pgmerek/japery/README.md

# japery
Portland State University ECE Capstone Team 26
