pgmerek/japery/documentation/README.md

# Documentation
All doumentation, reference material, or outside information should reside here

Final Report Google Doc (Draft): https://docs.google.com/document/d/1LwpEJCZxTwCMf6oirXwg-rZckvGhczSC2MAk1pbLXmk/edit#heading=h.k2z41lkf2acu

Verification LaTeX doc (draft): https://www.overleaf.com/read/xrfpnjqczpqf
