pgmerek/japery/rust_reference/README.md

Rust bibliography

Bibliography for Rust

[1] Jorge Aparic, A self-balancing robot coded in Rust, (2018), Github Repository, https://github.com/japaric/zen

[2] Stefan Kroboth, Rust on a Microcontroller, (2018), Github Repository,  https://github.com/stefan-k/STM32F303DISCOVERY

[3] A. Greig, A. Richter, J. Munns, J. Pallant, D. Egger, The Embedded Rust Book, (2019), Github Repository, https://rust-embedded.github.io/book

[4] [Various Authors], The Cargo Book, (2019), Github Repository, https://doc.rust-lang.org/stable/cargo/index.html

[5] [Various Authors], Template to develop bare metal applications for Cortex-M microcontrollers, (2019), Github Repository, https://github.com/rust-embedded/cortex-m-quickstart

[6] [Various Authors], Generate Rust register maps (`struct`s) from SVD files, (2019), Github Repository, https://github.com/rust-embedded/svd2rust

[7] [Various Authors], Jorge Aparic, Board Support Crate for the STM32F3DISCOVERY, (2019), Github Repository, https://github.com/japaric/f3

[8] Rust By Example, https://doc.rust-lang.org/rust-by-example/

[9] Crate: Cortex-M-Quickstart; A template for building applications for ARM Cortex-M microcontrollers, (2018), github repository, 
https://rust-embedded.github.io/cortex-m-quickstart/cortex_m_quickstart/

---------------------
Reference links

An API-- sort of. 
https://stm32.agg.io/rs/STM32F303.html#GPIOE

STM32F303 User Manual
https://www.st.com/content/ccc/resource/technical/document/user_manual/8a/56/97/63/8d/56/41/73/DM00063382.pdf/files/DM00063382.pdf/jcr:content/translations/en.DM0006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

STM32F303 Datasheet
https://www.st.com/resource/en/datasheet/stm32f303vc.pdf

STM32F303 Reference Manual
https://www.st.com/content/ccc/resource/technical/document/reference_manual/4a/19/6e/18/9d/92/43/32/DM00043574.pdf/files/DM00043574.pdf/jcr:content/translations/en.D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

------
