pgmerek/japery/hardware/motor/README.pdf

ECE 413: Senior Project Development II | Spring 2019

## DC Motor Measurements April 21, 2019

Student Name: Justin Patterson | Industry Sponsor: Galois Inc

To characterize a dc motor, (https://www.pololu.com/product/3262/specs) two experiments were conducted. The first experiment makes use of a Prony brake, where torque is calculated though measured force. A relationship between torque & angular speed, and torque & current is then observed. Further, we can determine the torque coefficient of the motor. In the second experiment, other motor parameters are determined such as the armature resistance and inductance, the electromotive force (emf) coefficient, and the friction coefficient.

## Prony Brake

Equations

The driving torque Tem of a dc motor is given by

Tem = kmΦpia | (1)

where, km is the torque coefficient, Φp is the excitation flux, and ia is the armature current.

The back emf of a dc motor is given by

E = keΦpω | (2)

where, ke is the emf coefficient, and ω is the angular speed of the shaft.

Assuming that the excitation flux Φp is constant, Km = kmΦp and Ke = keΦp can be made in (1) and
(2) respectively, without lack of generality.

Recall the relationship between torque and force. That is,

Tem = rFnet | (3)

where, r is the radius of the drive wheel.

Materials

- two 20-Newton spring scales
- shoelace
- tachometer
- power supply
- ammeter

1

motor measurements | 2

Procedure

Using the rated voltage of the motor, connect the leads to a power supply such that the drive wheel ro-tates in the clockwise direction. Using the tachometer and ammeter, record the angular speed and current, respectively. These measurements correspond to the no-load speed and no-load current, respectively. Note that under no load, the driving torque Tem = 0.

Attach each end of the shoelace to the Newton spring scales. Both ends should be under equal tension when placed under the stationary drive wheel (see Fig. 1). Record the speed, current, and the driving torque. The driving torque is calculated using (3). Note that the net force Fnet = F2 − F1, where F2 and F1 are the measured forces from the spring scales. Increase the prony brake height in 1 cm increments and record the speed, current, and torque. For higher driving torques, the prony brake height can be increased in 0.5 cm increments.

Repeat the process for the counter-clockwise direction of the motor. Plot speed vs torque and current vs torque. Using the current vs torque plot and (1), calculate the torque coefficient Km of the motor.

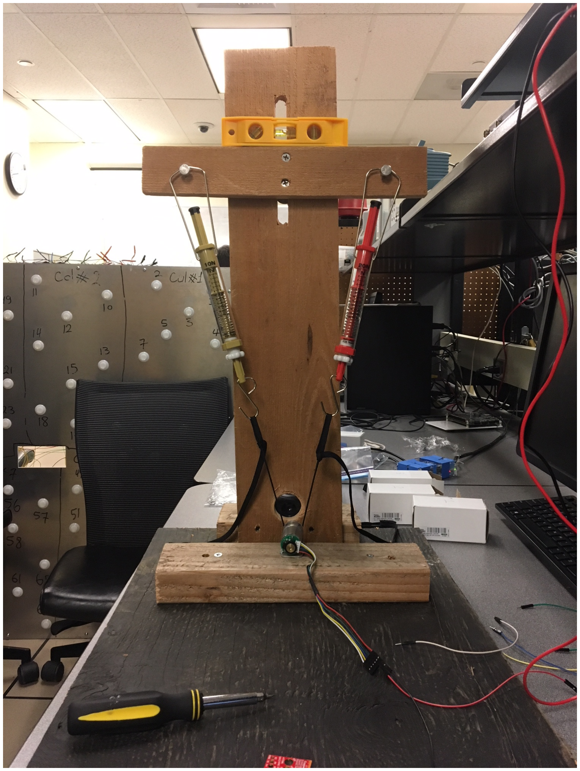
[picture p1: figure]

Figure 1: Prony brake setup

motor measurements | 3

## Other Measurements

Equations

A dc motor consists of an armature resistance Ra and inductance La. When rotating, the motor produces a back emf which is proportional to the angular speed of the shaft, given in (2). The electrical equation of a dc motor is given by

va = Raia + La

dia
dt + E | (4)

where, va is the applied armature voltage, ia is the armature current, and E is the back emf.

The mechanical equation is given by

J

dω
dt = Tem − TL − Bω | (5)

where, J is the moment of inertia of the load, TL is the load torque (external disturbance), and B is the friction coefficient.

Materials

- multimeter
- power supply
- tachometer

Procedure

Using the multimeter, measure the armature resistance and inductance. Starting at the rated dc voltage of the motor, measure the speed and current using the tachometer and ammeter, respectively. Calculate the back emf E using (4). Note that for a dc applied voltage, dia
dt = 0. Decrement the voltage in steps of 1-2 V and record the speed, current, and emf.

Repeat the process for the drive wheel rotating in the opposite direction. Plot the back emf vs speed. Using the plot and (2), calculate the emf coefficient Ke of the motor.

In addition, plot current vs rpm. Using (5) and (1), along with the Km value found in the prony brake experiment, calculate the friction coefficient B. Note that dω
dt = 0 and TL = 0 in this experiment.

## References

- Make a Prony Brake to Analyze Motor Performance (http://www.gearseds.com/files/sample_lesson2.pdf)
- Digital Control of Electrical Drives (https://www.springer.com/us/book/9780387259857)
