pgmerek/japery/hardware/motor/additional_data.xlsx

Sheet: motor1
resistance (ohms) | inductance (mH) | direction | rpm | voltage (V) | current (mA) | back emf (V)
11.1 | 15.3 | CW | 585.5 | 12 | 30.2 | 11.66478
 |  |  | 487.1 | 10 | 29 | 9.6781
 |  |  | 388.7 | 8 | 26.6 | 7.70474
 |  |  | 290.8 | 6 | 23.8 | 5.73582
 |  |  | 188 | 4 | 20.8 | 3.76912
 |  |  | 88.3 | 2 | 17.7 | 1.80353
 |  | CCW | 533.2 | 11 | 30.6 | 10.66034
 |  |  | 436 | 9 | 27.9 | 8.69031
 |  |  | 337.3 | 7 | 25.5 | 6.71695
 |  |  | 236.8 | 5 | 22.8 | 4.74692
 |  |  | 141 | 3 | 20 | 2.778
 |  |  | 38.6 | 1 | 16.2 | 0.82018

Sheet: motor2
resistance (ohms) | inductance (mH) | direction | rpm | voltage (V) | current (mA) | back emf (V)
11 | 15.6 | CW | 592.8 | 12 | 30.5 | 11.6645
 |  |  | 491 | 10 | 28.6 | 9.6854
 |  |  | 393.9 | 8 | 26.4 | 7.7096
 |  |  | 291.5 | 6 | 24.3 | 5.7327
 |  |  | 192.4 | 4 | 21.4 | 3.7646
 |  |  | 91.4 | 2 | 18 | 1.802
 |  | CCW | 537.9 | 11 | 31.3 | 10.6557
 |  |  | 440.1 | 9 | 28.8 | 8.6832
 |  |  | 338.9 | 7 | 26.3 | 6.7107
 |  |  | 239.1 | 5 | 23.9 | 4.7371
 |  |  | 139.5 | 3 | 20.8 | 2.7712
 |  |  | 43.4 | 1 | 16.6 | 0.8174
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
