pgmerek/japery/hardware/motor/data.xlsx

Sheet: motor1
direction | torque (N.mm) | rpm | current (mA)
CW | 0.00 | 579.5 | 33.3
 | 2.58 | 572.1 | 48.2
 | 7.60 | 514 | 114.6
 | 17.10 | 449.3 | 215.6
 | 29.45 | 367.5 | 335.3
 | 38.00 | 283.1 | 451
 | 45.60 | 217.5 | 561
CCW | 0.00 | 579.9 | 33.21
 | 3.80 | 543.2 | 75.6
 | 14.25 | 474.3 | 160
 | 22.99 | 409.1 | 276
 | 36.10 | 341.7 | 376
 | 41.80 | 301.7 | 443
 | 69.35 | 170.8 | 626

Sheet: motor2
direction | torque (N.mm) | rpm | current (mA)
CW | 0.00 | 587.1 | 36.4
 | 3.30 | 577.8 | 46.5
 | 9.50 | 506 | 130.6
 | 20.90 | 438.8 | 237.4
 | 34.20 | 363.8 | 344.8
 | 36.10 | 346.6 | 366.7
 | 40.85 | 316.3 | 433.8
CCW | 0.00 | 588.3 | 31.5
 | 3.80 | 558.3 | 65.3
 | 19.00 | 469.1 | 171.6
 | 28.50 | 404.2 | 284.3
 | 41.80 | 313.7 | 426.4
 | 44.65 | 270.3 | 472.2

Sheet: motor3
direction | torque (N.mm) | rpm | current (mA)
CW | 0.00 | 584.2 | 34.3
 | 12.35 | 466.4 | 157.9
 | 22.80 | 406.9 | 265.7
 | 35.15 | 335.4 | 374.4
 | 43.70 | 263.8 | 483.6
 | 48.50 | 214 | 550
CCW | 0.00 | 594 | 27.69
 | 19.00 | 453.5 | 209.5
 | 32.30 | 373.4 | 331.1
 | 38.95 | 308.6 | 432
 | 47.50 | 236.9 | 524
 | 51.30 | 186 | 593
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
