pgmerek/japery/documentation/diagrams/L0_diagram.png

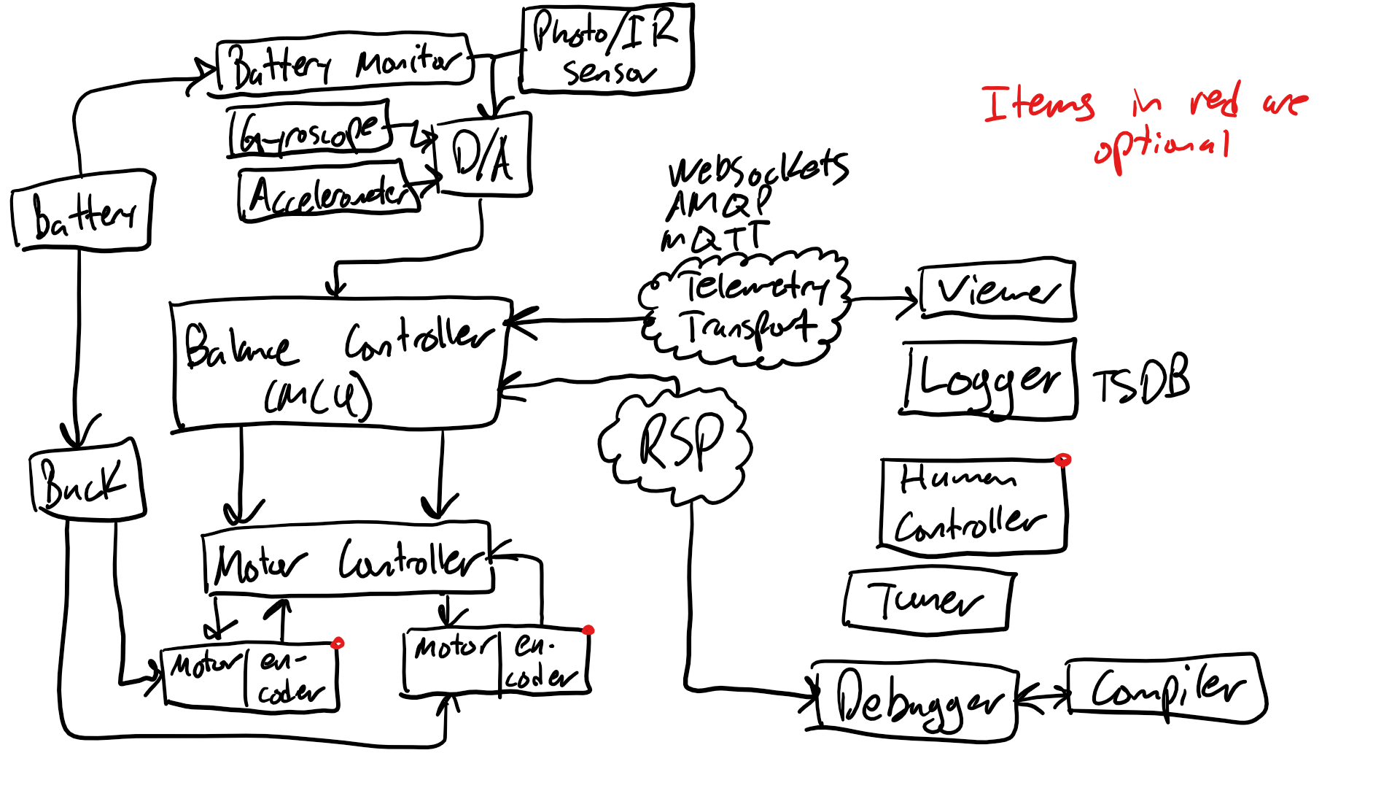
documentation/diagrams/L0_diagram.png
