pgmerek/japery/documentation/diagrams/motor_considerations.png

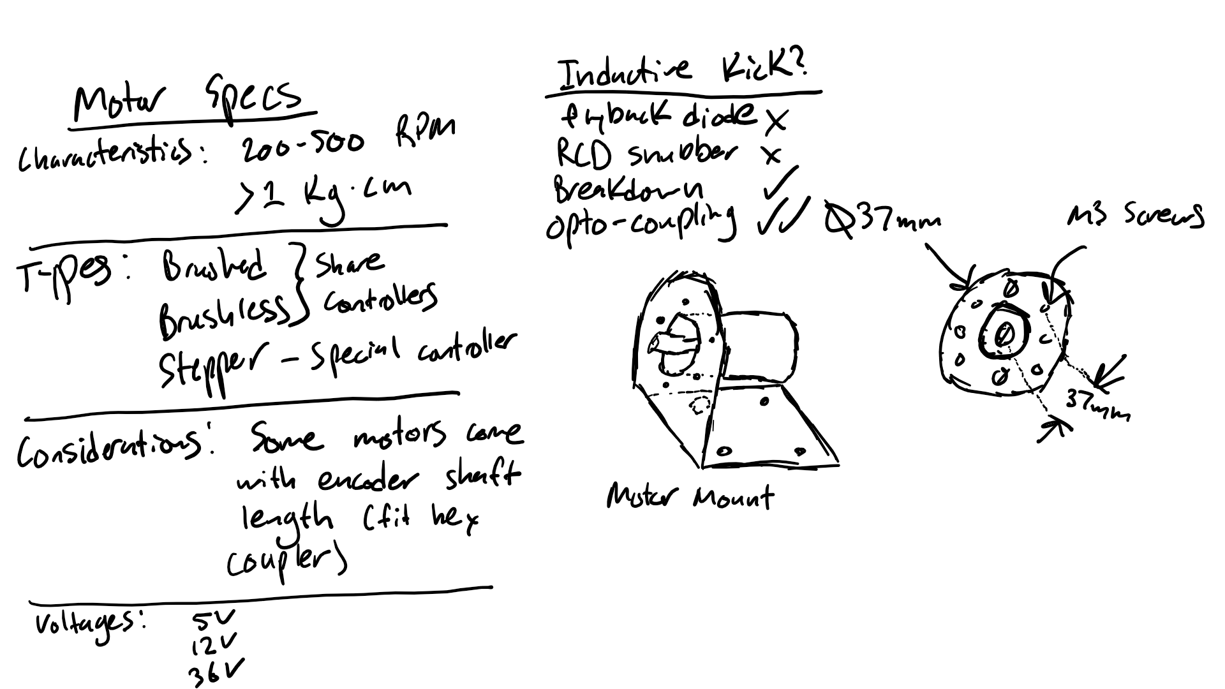
documentation/diagrams/motor_considerations.png
