pgmerek/japery/documentation/diagrams/motor_diagram.png

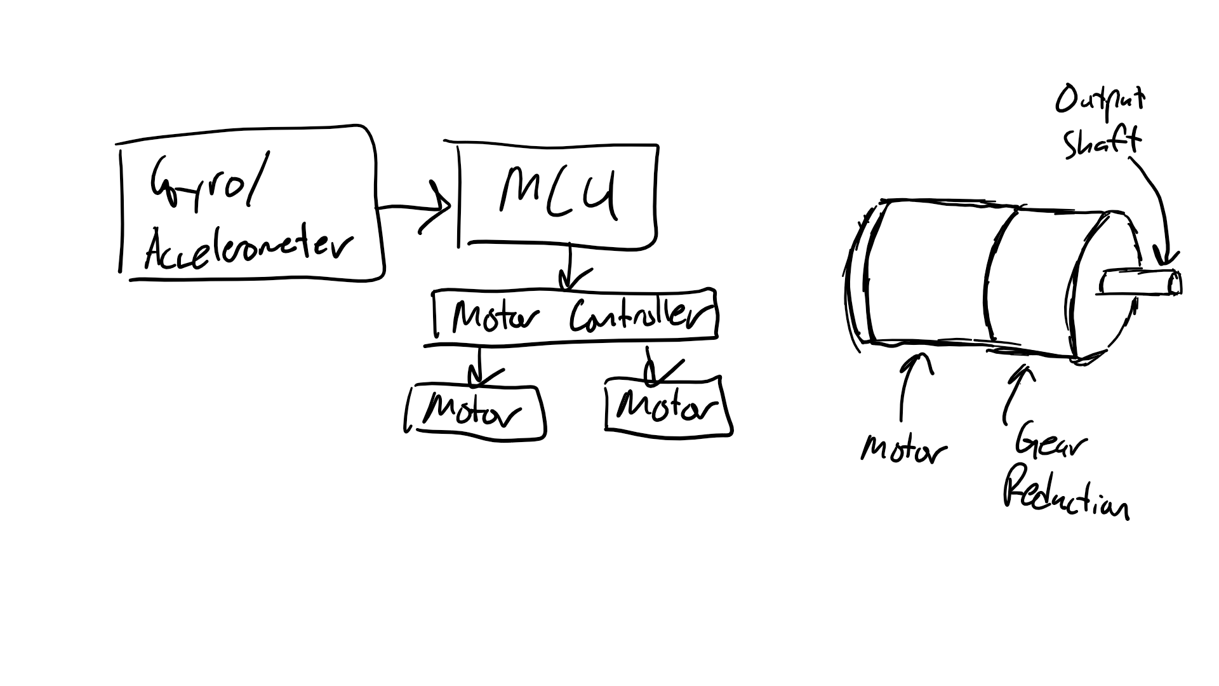
documentation/diagrams/motor_diagram.png
