pgmerek/japery/documentation/diagrams/pid_diagram.png

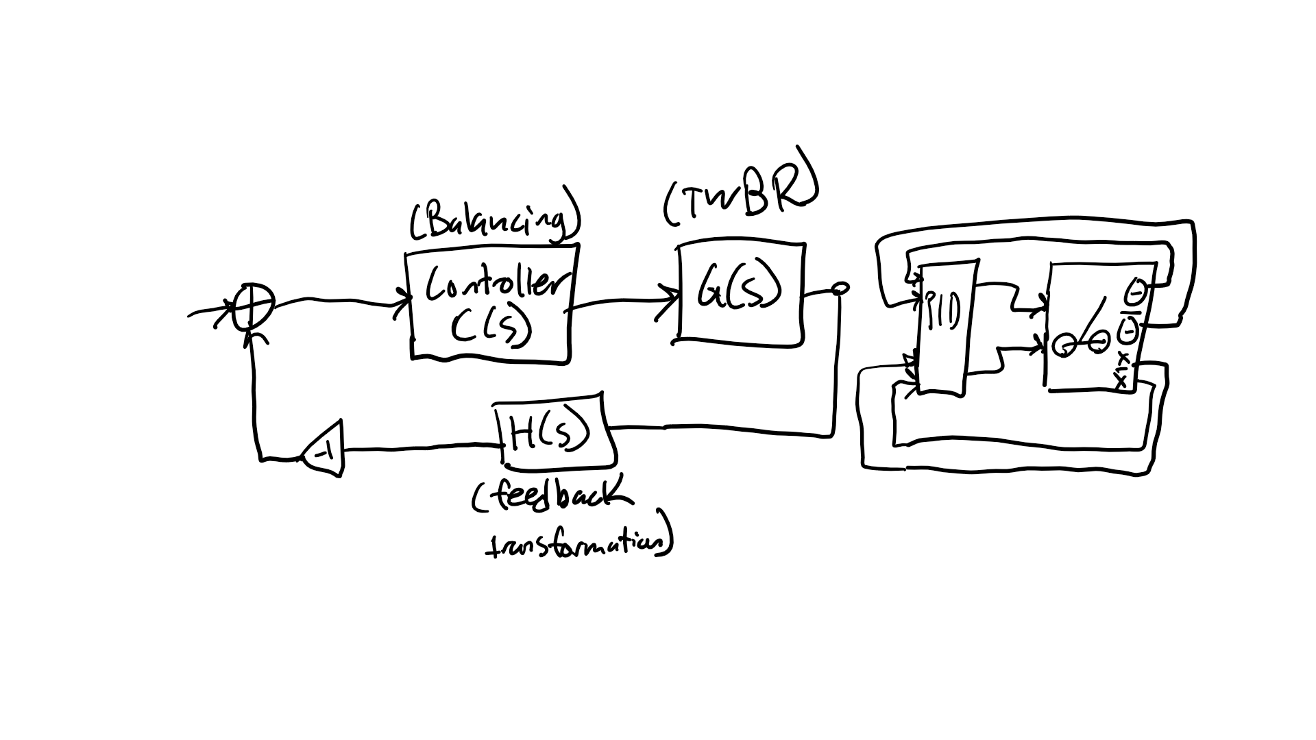
documentation/diagrams/pid_diagram.png
