pgmerek/japery/documentation/Arduino Prototype BOM - Sheet1.pdf

Part Description | Part Number | Price per part | Build Quantity | Order Quanity | Part Subtotal | Supplier | Notes | Data Sheet URL | URL
Arduino Uno | A000073 | $21.40 | 1 | 1 | $21.40 | Amazon | http://ww1.microchip.com/downloads/en/DeviceDoc/Atmel-7810-Automotive-Microcontrollers-ATmega328P_Datasheet.pdf https://www.amazon.com/ARDUINO-A000073-DEV-BRD-ATMEGA328/dp/B007R9TUJE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
Raspberry Pi Model 3B+ | $38.30 | 1 | 1 | $38.30 | Amazon | https://static.raspberrypi.org/files/product-briefs/Raspberry-Pi-Model-Bplus-Product-Brief.pdf https://www.amazon.com/ELEMENT-Element14-Raspberry-Pi-Motherboard/dp/B07BDR5PDW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
Samsung 32GB 95MB/s (U1) MicroSD EVO Select Memory Card with Adapter | MB-ME32GA/AM | $7.99 | 1 | 1 | $7.99 | Amazon | | | https://www.amazon.com/gp/product/B06XWN9Q99/ref=crt_ewc_title_huc_1?ie=UTF8&smid=ATVPDKIKX0DER&th=1
STMICROELECTRONICS STM32F3DISCOVERY EVAL KIT, STM32 F3 SERIES DISCOVERY | STM32F3DISCOVERY | $31.50 | 1 | 1 | $31.50 | Amazon | https://www.st.com/content/ccc/resource/technical/document/user_manual/8a/56/97/63/8d/56/41/73/DM00063382.pdf/files/DM00063382.pdf/jcr:content/translations/en.DM0006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 https://www.amazon.com/STMICROELECTRONICS-STM32F3DISCOVERY-EVAL-STM32-DISCOVERY/dp/B00HPLOSV4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
ST-LINK/V2(CN Version) ST MCU Microcontroller STM8 STM32 JTAG SWD SWIM In-circuit Debugger Programmer Emulator @XYGStudy | - | $36.99 | 1 | 1 | $36.99 | Amazon | in-circuit debugger/programmer for STM8
| | | | | | | and STM32 | https://www.st.com/resource/en/data_brief/st-link-slsh-v2.pdf | https://www.amazon.com/Microcontroller-circuit-Debugger-Programmer-Emulator/dp/B00C7W4IWA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
Pololu 9.7:1 Metal Gearmotor 25Dx48L mm LP 12V with 48 CPR Encoder | 3262 | $34.95 | 2 | 4 | $139.80 | Polulu | has an integrated 48 CPR quadrature encoder | https://www.pololu.com/product/3262/specs | https://www.pololu.com/product/3262/resources
Pololu 25D mm Metal Gearmotor Bracket Pair | 2676 | $7.45 | 1 | 1 | $7.45 | Polulu | Comes in a 2 pack | https://www.pololu.com/product/2676 | https://www.pololu.com/product/2676
Blomiky 2 Pack 11.1V 3S 2200mAh 25C Lipo Battery Pack with T Deans Plug and Balance Charger for RC Airplane Helicopter Car RC Truck Boat Quadcopter T 11.1V

Buck Boost Converter Display, DROK Buck-Boost Board DC 5.5-30V 12v to DC 0.5-30V 5v 24v Adjustable Constant Current Voltage Step UP Down Voltage Regulator

2200mAH 2 | - | $36.99 | 1 | 1 | $36.99 | Amazon | Includes Charger. Used Dean T plug | Could not locate datasheet | https://www.amazon.com/Blomiky-2200mAh-Airplane-Helicopter-Quadcopter/dp/B071XHXK69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
3A 35W Power Supply Module | - | $13.98 | 1 | 3 | $41.94 | Amazon | 3 A version, buck/boost converter | https://images-na.ssl-images-amazon.com/images/I/C128U5Z2hGS.pdf https://www.amazon.com/Converter-DROK-Buck-Boost-Adjustable-Regulator/dp/B0789QVKKF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
Adafruit Motor/Stepper/Servo Shield for Arduino v2.3 Kit | 1438 | $18.90 | 1 | 2 | $37.80 | Amazon | | Datasheet for motor driver (https://cdn-shop.adafruit.com/datasheets/TB6612FNG_datasheet_en_20121101.pdf) | https://www.amazon.com/Adafruit-Motor-Stepper-Shield-Arduino/dp/B00PUTH3B0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
GY-521 MPU-6050 MPU6050 3 Axis Accelerometer Gyroscope Module 6 DOF 6-
axis Accelerometer Gyroscope Sensor Module 16 Bit AD Converter Data Output IIC
I2C | MPU6050 | $5.79 | 1 | 3 | $17.37 | Amazon | http://www.haoyuelectronics.com/Attachment/GY-521/mpu6050.pdf https://www.amazon.com/MPU-6050-MPU6050-Accelerometer-Gyroscope-Converter/dp/B008BOPN40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
Pololu 1083 Universal Aluminum MOUNTING HUB for 6mm Shaft Pair, 4-40 Holes | 43220-262879 | $13.89 | 1 | 1 | $13.89 | Amazon | Adapter for motors to wheels | https://www.pololu.com/product/1083/specs | https://www.amazon.com/Pololu-Universal-Aluminum-MOUNTING-Shaft/dp/B00B887FX8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
80 x 10mm Black Robot Wheels | 595660 | $11.99 | 1 | 1 | $11.99 | Amazon | | https://www.pololu.com/product/1430/specs | https://www.amazon.com/80-10mm-Black-Robot-Wheels/dp/B00T3MQEU6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
Atomic Market HC-06 Bluetooth Serial Pass-Through Module Wireless Serial

VETOMILE 6-way Fuse Box Blade Fuse Block Holder Screw Nut Terminal 5A 10A 15A 20A Free Fuses LED Indicator Waterpoof Cover for Automotive Car Marine

MICTUNING 100PCS ATC/ATO Assorted Standard Blade Fuse Set - (2A 3A 5A 7.5A 10A 15A 20A 25A 30A 35A) - Car Truck SUV Boat Automotive Replacement Fuses | MIC-ABF-146 | $7.99 | 1 | 1 | $7.99 | Amazon | Includes lower current values such as 2A, 3A,

HVAZI 200pcs Metric M2.5 M3 304 Stainless Steel Hex Socket Head Cap Screws

Hilitchi 180pcs M4 Stainless Steel Hex Socket Head Cap Screws Nuts Assortment

HVAZI 205pcs Metric M2.5 M3 M4 M5 M6 M8 M10 M12 Stainless Steel Nylon Hex

Communication Compatible with Arduino | HC-06 | $8.99 | 1 | 1 | $8.99 | Amazon | MIGHT BE UNNECESSARY | https://www.olimex.com/Products/Components/RF/BLUETOOTH-SERIAL-HC-06/resources/hc06.pdf https://www.amazon.com/Pass-Through-Communication-Compatible-Atomic-Market/dp/B00TNOO438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
Boat | - | $9.99 | 1 | 1 | $9.99 | Amazon | Uses ATC fuses | N/A | https://www.amazon.com/VETOMILE-Terminal-Indicator-Waterpoof-Automotive/dp/B074XYY967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
5A, 7.5A | https://www.littelfuse.com/~/media/automotive/datasheets/fuses/passenger-car-and-commercial-vehicle/blade-fuses/littelfuse_atof_datasheet.pdf https://www.amazon.com/MICTUNING-100PCS-Assorted-Standard-Blade/dp/B07BS7L7JN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
Assortment Kit | BTM25M3200P | $11.99 | 1 | 1 | $11.99 | Amazon | M2.5, M3 Hex socket screw assortment | N/A | https://www.amazon.com/HVAZI-200pcs-Metric-Stainless-Assortment/dp/B01MXS6JMR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
Kit with Box (M4) | HSH180 | $12.99 | 1 | 1 | $12.99 | Amazon | M4 Socket screw and m4 nut assortment | N/A | https://www.amazon.com/Hilitchi-180pcs-Stainless-Socket-Assortment/dp/B017N7ZI72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
Lock Nut Assortment Kit | FSLM205P | $14.90 | 1 | 1 | $14.90 | Amazon | Locknut assortment | N/A | https://www.amazon.com/HVAZI-205pcs-Metric-Stainless-Assortment/dp/B06W5SXD88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
TOTAL FOR ONE UNIT | $360.52
TOTAL INCLUDING SPARE PARTS | $510.26
