pgmerek/japery/(list of files, cad)

Other CAD files:
hardware/schematics/Assembly.f3z
hardware/schematics/Base.f3d
hardware/schematics/Front.f3d
hardware/schematics/Left Side.f3d
hardware/schematics/Right Side.f3d
hardware/schematics/Top.f3d
