pgmerek/japery/hardware/twip_measurements.pdf

ECE 413: Senior Project Development II | Spring 2019

## TWIP Measurements May 3, 2019

Student Name: Justin Patterson | Industry Sponsor: Galois Inc
description | variable | value | units
length of track | d | 0.161 | m
length to COG | l | 0.047 | m
radius of a wheel | r | 0.04 | m
mass of platform | M | 1.22 | kg
mass of a wheel | Mw | [0.02, 0.021] | kg
mass of the pendulum | m | 0 | kg
moment of inertia of a wheel | Iw | [32e-6, 33.6e-6] | kg-m²
moment of inertia of the platform and pendulum about z-axis | Ip | [2.601e-3, 4.002e-3] | kg-m²
moment of inertia of platform about y-axis | Im | [1.776e-3, 2.056e-3] | kg-m²
moment of inertia of motor output shaft | J | ? | kg-m²
electromotive force constant | Ke | 0.1893 | V/rad/sec
motor torque constant | Kt | 0.0993 | N-m/A
motor friction | b | ?
motor resistance | R | 11.1 | Ω
motor inductance | L | 15.38e-3 | H
motor deadzone | d | 0.2 | V

## Notes

- Mass of each battery ∈ [0.164 kg, 0.165 kg]
- Mass of all panels = 0.369 kg
- Mass of fusebox = 0.078 kg
- Moment of inertia of platform/pendulum approximated using Parallel Axis Theorem

1
