pgmerek/japery/Calibration_GUI/gui1.0.JPG

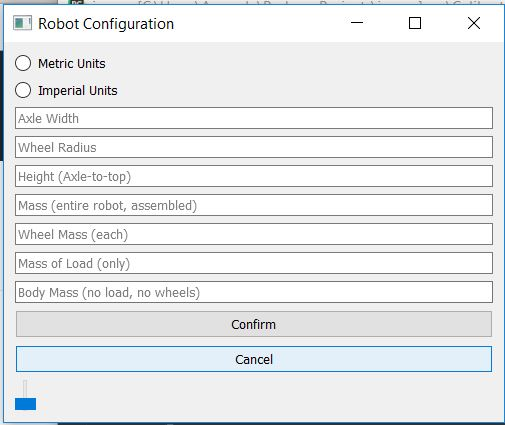
Calibration_GUI/gui1.0.JPG
