pgmerek/japery/Calibration_GUI/gui2.0.PNG

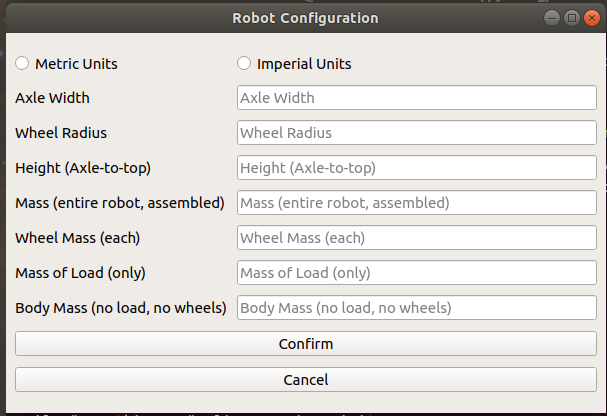
Calibration_GUI/gui2.0.PNG
