pgmerek/japery/(commit log)

2019-01-12 Adding motor diagram and adminstrative documents.
2019-02-23 Confirm button displays the contents of text entries. Cancel button placeholder implemented
2019-02-26 Update main.py
    Filled with debug code. Confirm button now creates a dict from the variables entered in QLineEdit fields.
2019-02-27 Update main.py
    Removed Imperial and Metric radio buttons, added drop-down menus for unit selection. Dropdowns don't do anything yet.
2019-02-27 Update main.py
    Changed all mentions of mass to weight. Removed imperial and metric radio buttons. Added dropdowns. Dropdowns don't do anything yet.
2019-02-27 Update main.py
    Added units to print statements, established ability to detect state between widgets.
2019-04-05 Bluetooth and I2c practice files
2019-04-11 Add motor measurements
    [additional_data.xlsx, data.xlsx]
2019-04-13 Adding cad files for the first prototype robot
    [Assembly.f3z, Base.f3d, Front.f3d, Left Side.f3d, Right Side.f3d, Top.f3d]
2019-04-22 Add friction coefficient calculations
    [additional_data.xlsx, data.xlsx]
2019-05-13 Adding meeting notes and modified I2C test script.
2019-06-14 Add files via upload
    Bill of Materials
